sammothxc/tactical-tenkey/README.md

# tactical-tenkey
A tactile, tactical tenkey that doubles as a USB/BT numpad

## TODO
- [ ] fix menu timeout glitch
- [ ] fix battery level
- [ ] fix pairing error (bt, linux)
