sammothxc/tactical-tenkey/case/tactical-tenkey-case.FCStd

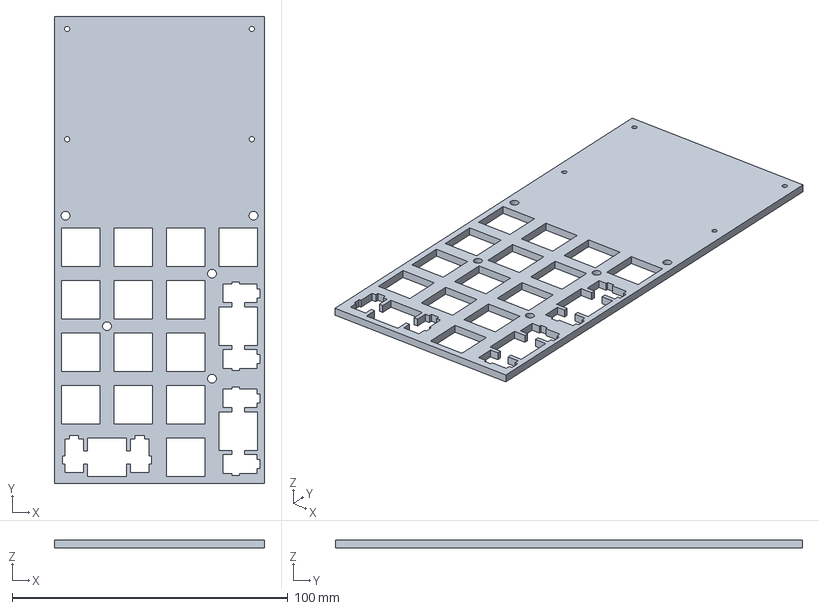
[picture p1: CAD file, 2026-06-15]
case/tactical-tenkey-case.FCStd
76.2 x 169.6 x 2.80 mm
