sammothxc/tactical-tenkey/case/plate.dxf

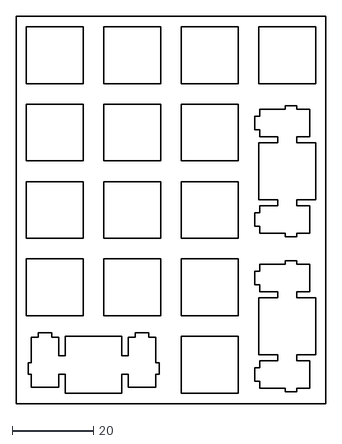
[picture p2: CAD file, 2026-03-09]
case/plate.dxf
76.2 x 95.2
