sammothxc/tactical-tenkey/pcb/tactical-tenkey.kicad_pcb

## KiCad design pcb/tactical-tenkey.kicad_pcb (2026-04-23)

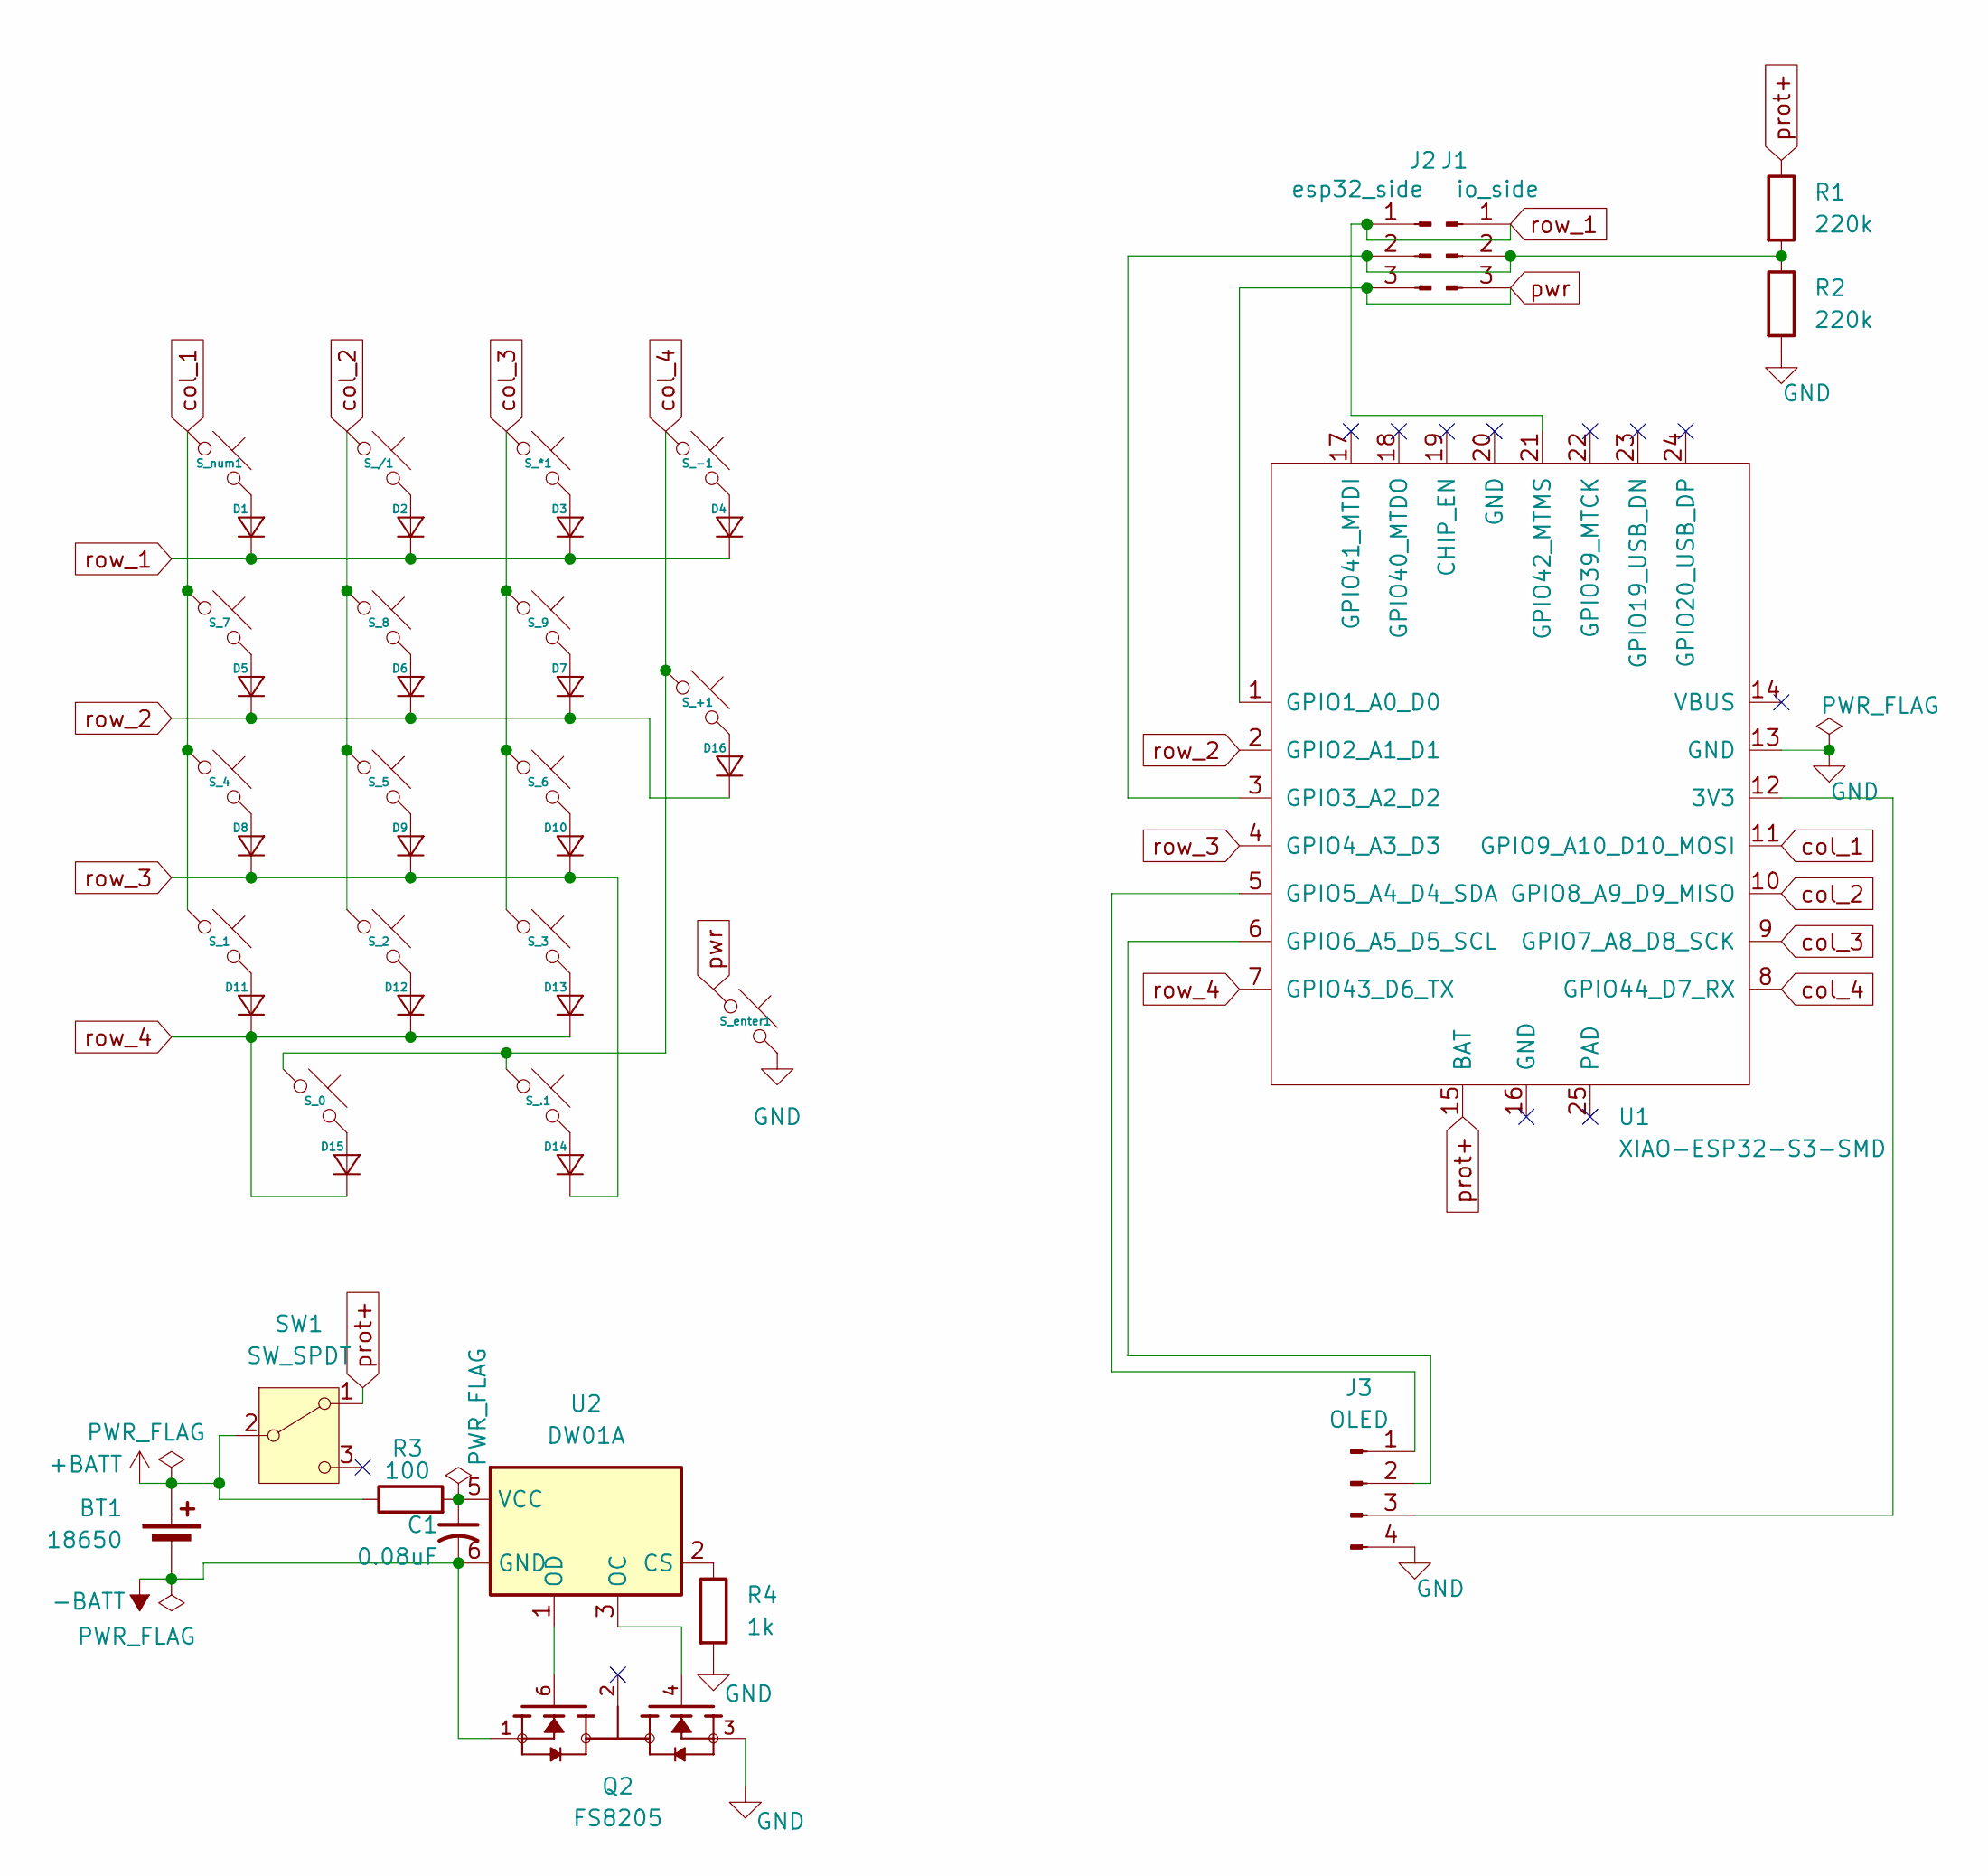
[picture p3: schematic tactical-tenkey.kicad_sch]

Parts:
BT1: 18650; PinHeader_1x02_P2.54mm_Vertical
C1: 0.08uF; CP_Radial_Tantal_D4.5mm_P5.00mm
D1, D2, D3, D4, D5, D6, D7, D8, D9, D10, D11, D12, D13, D14, D15, D16: Diode_DO-35
J1: io_side; PinHeader_1x03_P2.54mm_Vertical
J2: esp32_side; PinHeader_1x03_P2.54mm_Vertical
J3: OLED; PinHeader_1x04_P2.54mm_Vertical
Q2: FS8205; SOT95P280X145-6N; PARTREV 1.9
R1, R2: 220k; R_Axial_DIN0207_L6.3mm_D2.5mm_P10.16mm_Horizontal
R3: 100; R_Axial_DIN0207_L6.3mm_D2.5mm_P10.16mm_Horizontal
R4: 1k; R_Axial_DIN0207_L6.3mm_D2.5mm_P10.16mm_Horizontal
SW1: SW_SPDT; SS-12F23G5
S_0: Hotswap_MX_Plated_2.00u
S_1, S_2, S_3, S_4, S_5, S_6, S_7, S_8, S_9, S_.1: Hotswap_MX_Plated_1.00u
S_*1: Hotswap_MX_Plated_1.00u
S_+1: Hotswap_MX_Plated_2.00u
S_-1: Hotswap_MX_Plated_1.00u
S_/1: Hotswap_MX_Plated_1.00u
S_enter1: Hotswap_MX_Plated_2.00u
S_num1: Hotswap_MX_Plated_1.00u
U1: XIAO-ESP32-S3-SMD; XIAO-ESP32-S3-SMD_PAD
U2: DW01A; SOT-23-6

Connections:
+BATT: BT1.1 (+), R3.1, SW1.2 (B)
-BATT: BT1.2 (-), C1.2, Q2.1, U2.6 (GND)
GND: J3.4, Q2.3, R2.2, R4.2, S_enter1.2, U1.13 (GND)
unnamed: D1.2 (A), S_num1.2
unnamed: D2.2 (A), S_/1.2
unnamed: D3.2 (A), S_*1.2
unnamed: D4.2 (A), S_-1.2
unnamed: D5.2 (A), S_7.2
unnamed: D6.2 (A), S_8.2
unnamed: D7.2 (A), S_9.2
unnamed: D8.2 (A), S_4.2
unnamed: D9.2 (A), S_5.2
unnamed: D10.2 (A), S_6.2
unnamed: D11.2 (A), S_1.2
unnamed: D12.2 (A), S_2.2
unnamed: D13.2 (A), S_3.2
unnamed: D14.2 (A), S_.1.2
unnamed: D15.2 (A), S_0.2
unnamed: D16.2 (A), S_+1.2
unnamed: J1.2, J2.2, R1.2, R2.1, U1.3 (GPIO3_A2_D2)
unnamed: J3.1, U1.5 (GPIO5_A4_D4_SDA)
unnamed: J3.2, U1.6 (GPIO6_A5_D5_SCL)
unnamed: J3.3, U1.12 (3V3)
unnamed: R4.1, U2.2 (CS)
unnamed: Q2.4, U2.3 (OC)
unnamed: Q2.6, U2.1 (OD)
unnamed: C1.1, R3.2, U2.5 (VCC)
col_1: S_1.1, S_4.1, S_7.1, S_num1.1, U1.11 (GPIO9_A10_D10_MOSI)
col_2: S_2.1, S_5.1, S_8.1, S_/1.1, U1.10 (GPIO8_A9_D9_MISO)
col_3: S_3.1, S_6.1, S_9.1, S_*1.1, U1.9 (GPIO7_A8_D8_SCK)
col_4: S_0.1, S_+1.1, S_-1.1, S_.1.1, U1.8 (GPIO44_D7_RX)
prot+: R1.1, SW1.1 (A), U1.15 (BAT)
pwr: J1.3, J2.3, S_enter1.1, U1.1 (GPIO1_A0_D0)
row_1: D1.1 (K), D2.1 (K), D3.1 (K), D4.1 (K), J1.1, J2.1, U1.21 (GPIO42_MTMS)
row_2: D5.1 (K), D6.1 (K), D7.1 (K), D16.1 (K), U1.2 (GPIO2_A1_D1)
row_3: D8.1 (K), D9.1 (K), D10.1 (K), D14.1 (K), U1.4 (GPIO4_A3_D3)
row_4: D11.1 (K), D12.1 (K), D13.1 (K), D15.1 (K), U1.7 (GPIO43_D6_TX)

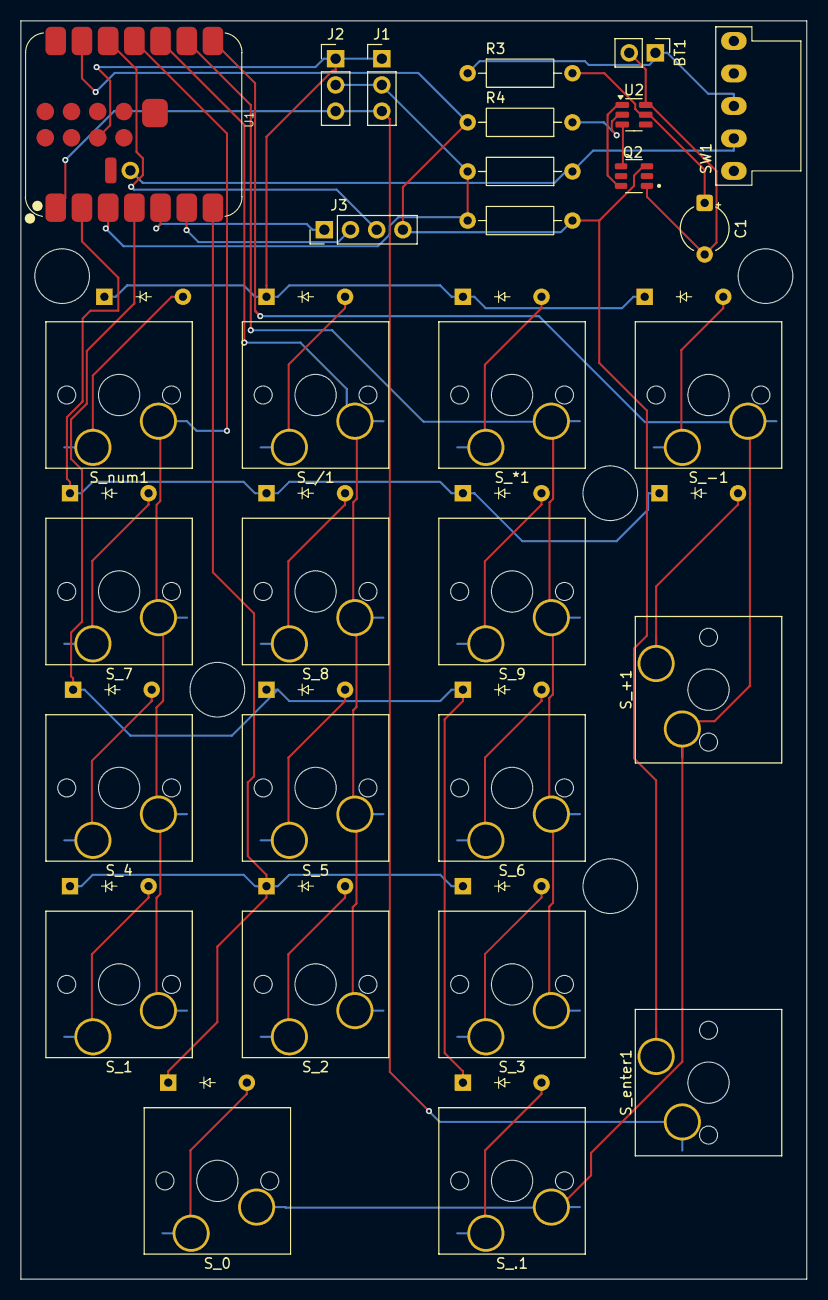
[picture p4: board tactical-tenkey.kicad_pcb from above]

Board: 2 copper layers, 76.2 x 122.0 mm, 46 parts (0 on the bottom side), 37 nets.
