sammothxc/tactical-tenkey/include/icons.h

#ifndef ICONS_H
#define ICONS_H

#define ICON_WIDTH 11
#define ICON_HEIGHT 11
#define LOGO_WIDTH 48
#define LOGO_HEIGHT 48


//       #
//       # #
//       #   #
//   #   #     #
//     # #   #
//       # #
//     # #   #
//   #   #     #
//       #   #
//       # #
//       #
static const unsigned char ICON_BLE[] = {
    0x20, 0x00,
    0x60, 0x00,
    0xa0, 0x00,
    0x28, 0x01,
    0xb0, 0x00,
    0x60, 0x00,
    0xb0, 0x00,
    0x28, 0x01,
    0xa0, 0x00,
    0x60, 0x00,
    0x20, 0x00
};



//           #
//         # # #
//           #     # #
//     #     #     # #
//   # # #   #   #
//     #     # #
//       #   #
//         # #
//           #
//         # # #
//         # # #
static const unsigned char ICON_USB[] = {
    0x20, 0x00,
    0x70, 0x00,
    0x20, 0x03,
    0x24, 0x03,
    0xae, 0x00,
    0x64, 0x00,
    0x28, 0x00,
    0x30, 0x00,
    0x20, 0x00,
    0x70, 0x00,
    0x70, 0x00
};



//   # # # # # # # # #
//   #               #
//   #   #   #   #   #
//   #               #
//   #   #   #   #   #
//   #               #
//   #   #   #   #   #
//   #               #
//   #       #       #
//   #               #
//   # # # # # # # # #
static const unsigned char ICON_NUMPAD[] = {
    0xfe, 0x03,
    0x02, 0x02,
    0xaa, 0x02,
    0x02, 0x02,
    0xaa, 0x02,
    0x02, 0x02,
    0xaa, 0x02,
    0x02, 0x02, 
    0x22, 0x02,
    0x02, 0x02,
    0xfe, 0x03
};



//     # # #
//   # # # # #
//   #       #
//   #   #   #
//   #   #   #
//   #   #   #
//   #   #   #
//   #       #
//   #   #   #
//   #       #
//   # # # # #
static const unsigned char ICON_LOWBATT[] = {
    0x70, 0x00,
    0xf8, 0x00,
    0x88, 0x00,
    0xa8, 0x00,
    0xa8, 0x00,
    0xa8, 0x00,
    0xa8, 0x00,
    0x88, 0x00,
    0xa8, 0x00,
    0x88, 0x00,
    0xf8, 0x00
};



//     # # #              
//   # # # # #   #       #
//   # # # # #   # # # # #
//   # # # # #   # # # # #
//   #       #   # # # # #
//     # # #       # # #  
//   # # # # #   #       #
//   # # # # #   # # # # #
//   # # # # #   # # # # #
//   #       #   # # # # #
//                 # # #  
static const unsigned char ICON_WINDOWS[] = {
    0x0e, 0x00,
    0x5f, 0x04,
    0xdf, 0x07,
    0xdf, 0x07,
    0xd1, 0x07,
    0x8e, 0x03,
    0x5f, 0x04,
    0xdf, 0x07,
    0xdf, 0x07,
    0xd1, 0x07,
    0x80, 0x03
};



//               # #
//             # #
//             #
//       # # #   # # #
//     # # # # # # # # #
//   # # # # # # # # #
//   # # # # # # # #
//   # # # # # # # #
//   # # # # # # # # #
//     # # # # # # # # #
//       # #       # #
static const unsigned char ICON_APPLE[] = {
    0xc0, 0x00,
    0x60, 0x00,
    0x20, 0x00,
    0xdc, 0x01,
    0xfe, 0x03,
    0xff, 0x01,
    0xff, 0x00,
    0xff, 0x00,
    0xff, 0x01,
    0xfe, 0x03,
    0x8c, 0x01
};



static unsigned char LOGO[] = {
    0x00,0x00,0xf8,0x1f,0x00,0x00,0x00,0x00,0xff,0xff,0x00,0x00,
    0x00,0xe0,0xff,0xff,0x07,0x00,0x00,0xf0,0xff,0xff,0x0f,0x00,
    0x00,0xfc,0xff,0xff,0x3f,0x00,0x00,0xfe,0xff,0xff,0x7f,0x00,
    0x00,0xff,0xff,0xff,0xff,0x00,0x80,0xff,0xff,0xff,0x9f,0x01,
    0xc0,0xff,0xff,0xff,0x6f,0x03,0xe0,0xff,0xff,0xff,0x7f,0x07,
    0xf0,0xff,0xff,0xff,0x9f,0x0f,0xf0,0xff,0xff,0xff,0xef,0x0f,
    0x78,0x00,0x00,0x00,0x0e,0x1f,0xbc,0xff,0xff,0xff,0xfc,0x3f,
    0xdc,0xff,0xff,0x7f,0xfd,0x3f,0x1c,0x00,0x00,0x80,0xfd,0x3f,
    0x1e,0x00,0x00,0x80,0xfd,0x7f,0x1e,0x00,0x00,0x80,0xfd,0x7f,
    0x1e,0x00,0x00,0x80,0xfd,0x7f,0x1f,0x00,0x00,0x80,0xfe,0xff,
    0x1f,0x00,0x00,0x00,0xff,0xff,0xff,0x7f,0x60,0xff,0xff,0xff,
    0xff,0x7f,0x60,0xff,0xff,0xff,0xff,0x7f,0x60,0xff,0xff,0xff,
    0xff,0x7f,0x60,0xff,0xff,0xff,0xff,0x7f,0x60,0xff,0xff,0xff,
    0xff,0x7f,0x60,0xff,0xff,0xff,0xff,0x7f,0x60,0xff,0xff,0xff,
    0xff,0x7f,0x60,0xff,0xff,0xff,0xfe,0x7f,0x60,0xff,0xff,0x7f,
    0xfe,0x7f,0x60,0xff,0xff,0x7f,0xfe,0x7f,0x60,0xff,0xff,0x7f,
    0xfc,0x7f,0x60,0xff,0xff,0x3f,0xfc,0x7f,0x60,0xff,0xff,0x3f,
    0xfc,0x7f,0x60,0xff,0xff,0x3f,0xf8,0x7f,0x60,0xff,0xff,0x1f,
    0xf0,0x7f,0x60,0xff,0xff,0x0f,0xf0,0x7f,0x60,0xff,0xff,0x0f,
    0xe0,0x7f,0x60,0xff,0xff,0x07,0xc0,0x7f,0x60,0xff,0xff,0x03,
    0x80,0x7f,0x60,0xff,0xff,0x01,0x00,0x7f,0x60,0xff,0xff,0x00,
    0x00,0x7e,0xa0,0xff,0x7f,0x00,0x00,0x7c,0xc0,0xff,0x3f,0x00,
    0x00,0xf0,0xff,0xff,0x0f,0x00,0x00,0xe0,0xff,0xff,0x07,0x00,
    0x00,0x00,0xff,0xff,0x00,0x00,0x00,0x00,0xf8,0x1f,0x00,0x00
};

#endif
