sammothxc/tactical-tenkey/(commit log)

2026-02-10 very basic math prototype
2026-02-12 rest in peace, esp32c6 doesn't have USB HID capability so esp32c3 it is
    [main.cpp]
2026-02-12 dev board pins
2026-02-16 pcb boilerplate
    [tactical-tenkey.kicad_pcb, tactical-tenkey.kicad_sch]
2026-02-16 battery protection
    [tactical-tenkey.kicad_pcb, tactical-tenkey.kicad_sch]
2026-02-16 xiao esp32s3
2026-02-16 correct led pin
2026-02-17 pcb layout
    [tactical-tenkey.kicad_pcb, tactical-tenkey.kicad_sch]
2026-02-26 working on the case
    [plate.dxf, tactical-tenkey-case.FCStd, tactical-tenkey.kicad_pcb]
2026-03-09 fix stabilizer orientation on plate
    [plate.dxf]
2026-03-09 case development
    [tactical-tenkey-case.FCStd, tactical-tenkey.kicad_pcb, tactical-tenkey.kicad_sch]
2026-03-10 footprint and pcb final edits (pre silkscreen art)
    [tactical-tenkey-case.FCStd, tactical-tenkey.kicad_pcb]
2026-03-11 final pcb touches
    [tactical-tenkey-case.FCStd, tactical-tenkey.kicad_pcb]
2026-03-11 final pcb touches for real this time
    [tactical-tenkey.kicad_pcb]
2026-03-28 flip display, use pin 3 for row 1
    [main.cpp]
2026-04-23 fix battery mgmt not working after switching off
    [tactical-tenkey.kicad_pcb, tactical-tenkey.kicad_sch]
2026-04-24 major progress: help pages rework, numpad mode functional, macro menu combo fix, toggleable nav/num mode, and send result function fixed
    [main.cpp]
2026-04-25 quick binds, settings menu, ui glitch fixes, and clear key bug fixes
    [main.cpp]
2026-04-25 macro fix. ble coming soon to theaters near u
    [main.cpp]
2026-04-26 fix ble on macos, nameless listing on linux, and add zoom in/out functionality in numpad nav mode
    [hid_ble.cpp, hid_ble.h, hid_usb.cpp, main.cpp]
2026-04-26 fix zomm in/out on macos with zoom modifier settings option
    [hid_ble.cpp, hid_ble.h, main.cpp]
2026-04-26 fix linux bt connection issues
    [build_scripts.py, hid_ble.cpp]
2026-04-28 bottom plate ncn code
    [tactical-tenkey-case.FCStd]
2026-05-24 case edits
    [tactical-tenkey-case.FCStd]
2026-05-30 fix issue where 5 was firing on-release instead of on-press
    [main.cpp]
2026-05-30 fix BLE advertisement, now pairs with windows
    [hid_ble.cpp]
2026-05-31 fix numpad keys to be numlock independent
    [hid_usb.cpp]
2026-05-31 fix cursor movement on windows and mac, and add host os icon to status bar
    [hid_ble.cpp, hid_usb.cpp, icons.h, main.cpp]
2026-05-31 fix number keys not working in BLE mode on windows
    [hid_ble.cpp]
2026-05-31 v1 released! celebrating bug-free bluetooth!!
    [hid_ble.cpp, hid_ble.h, main.cpp]
2026-05-31 battery level implementation in progress, and settings edits
2026-05-31 quick bind macro key fire logic fix
    [main.cpp]
2026-06-15 front plate edits
    [tactical-tenkey-case.FCStd]
